0leg19/esp-32_based_terminal/diagram/ESP32_wiring_diagram.pdf

# ESP32 RFID Terminal · Wiring Diagram

## Board: ESP32 DevKit V1 (DOIT, 30 pins) · top view, USB at the bottom

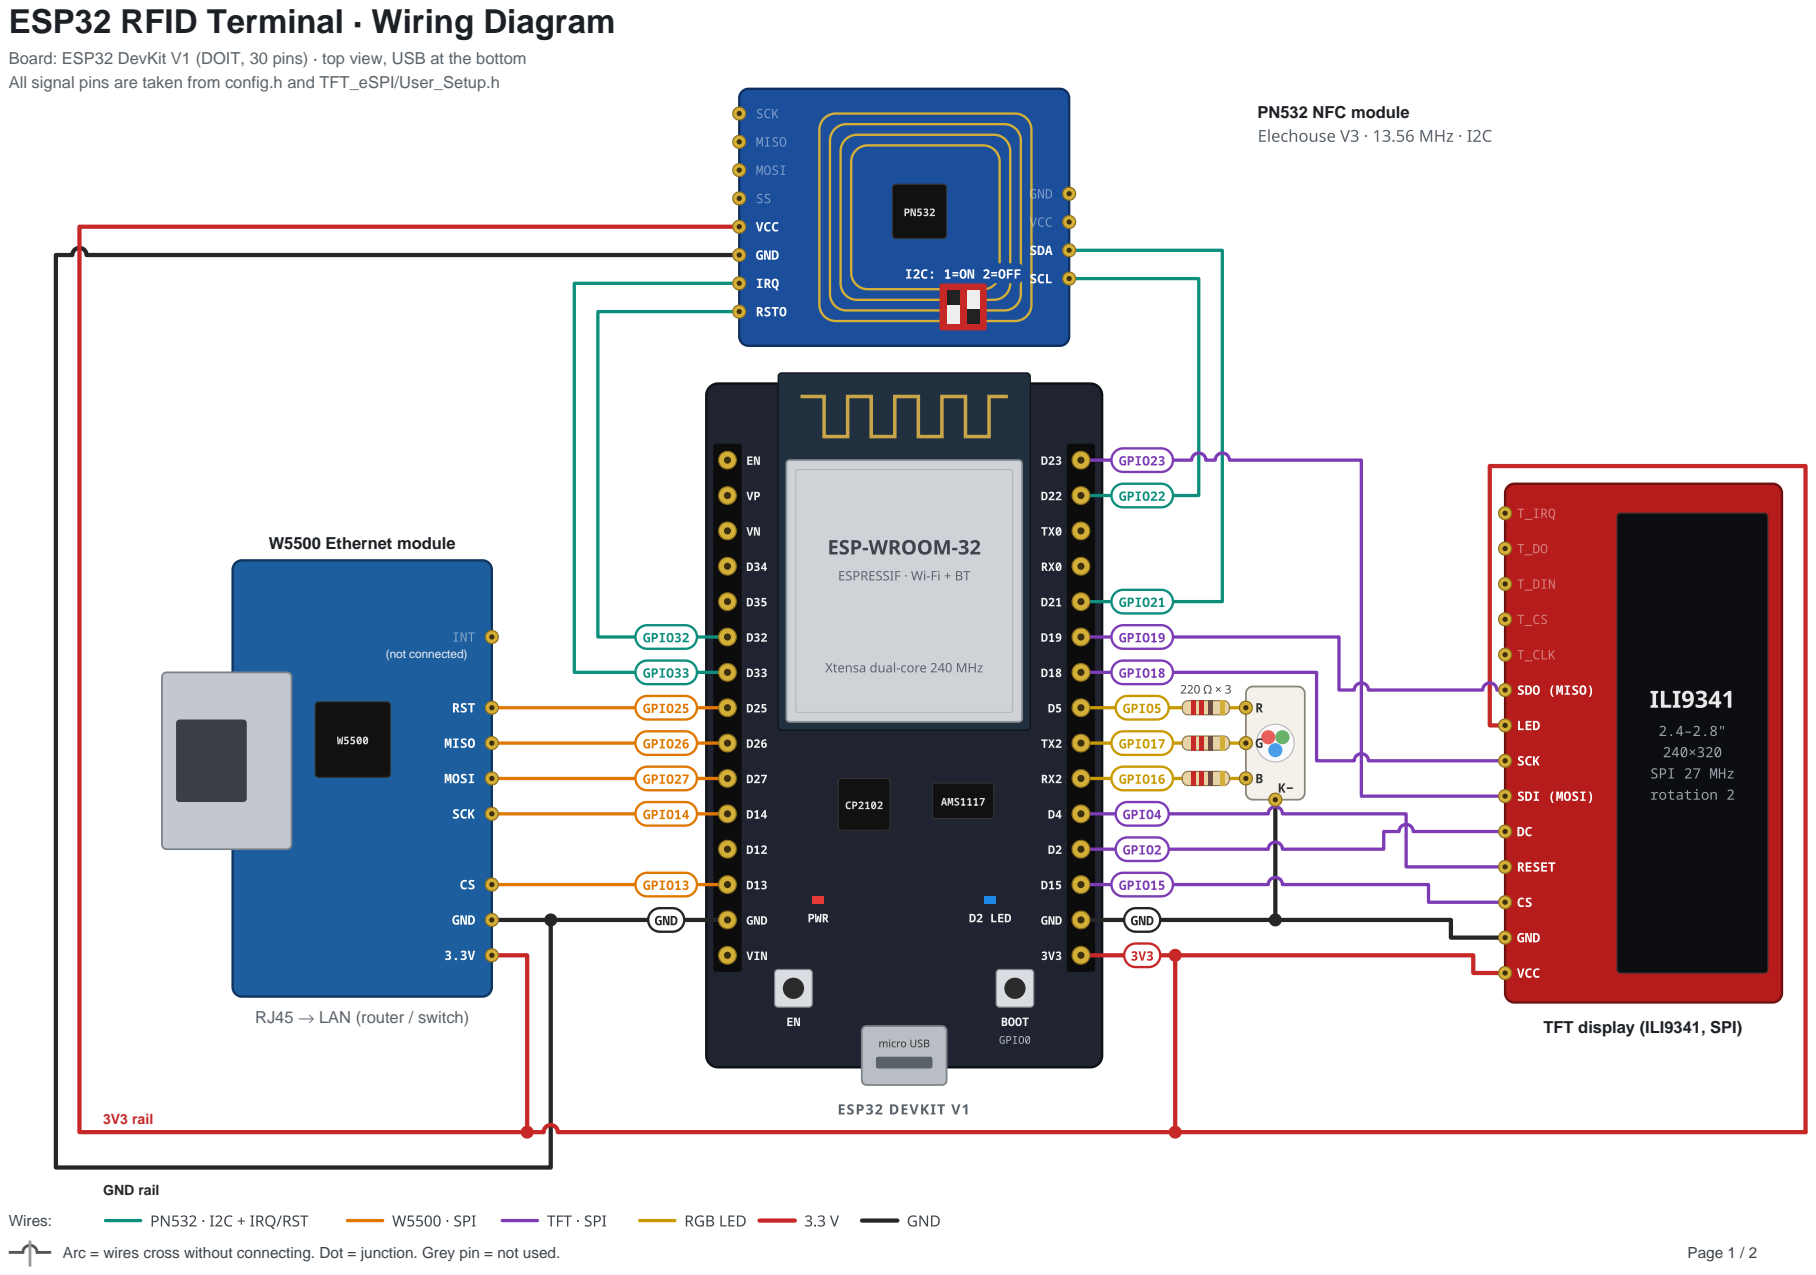
[picture p43: page 1]

All signal pins are taken from config.h and TFT_eSPI/User_Setup.h

ESPRESSIF · Wi-Fi + BT

Xtensa dual-core 240 MHz
